yuxiaolejs/models/nuc-1u-mount-PartA_NUC_tray.stl

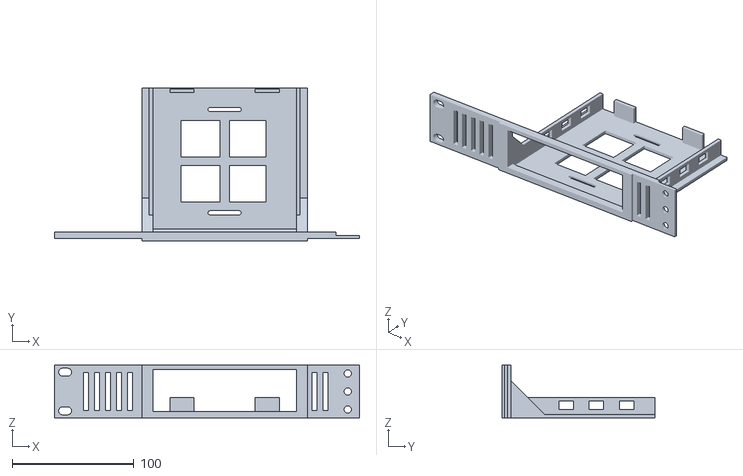
[picture p1: CAD file, 2026-07-30]
nuc-1u-mount-PartA_NUC_tray.stl
251.0 x 125.5 x 43.6
