yuxiaolejs/models/rack-panel.FCStd

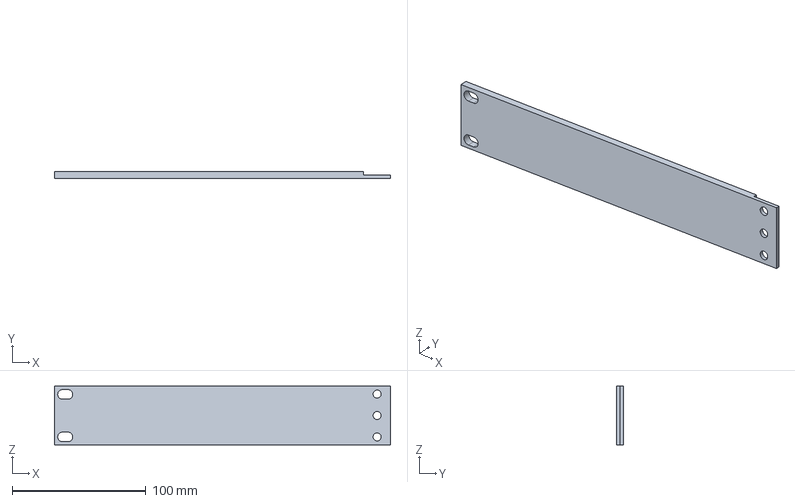
[picture p2: CAD file, 2026-07-30]
rack-panel.FCStd
251.0 x 5.00 x 44.0 mm
