yuxiaolejs/models/(commit log)

2026-07-30 Add parametric 1U NUC mount generator, forked from rack-panel
    Generator for a two-part 19" 1U rack mount holding an Intel NUC 11 slim
    (117 x 112 x 37). Both halves land at 251.0 mm to fit the 256 bed.
    Rack geometry corrected against EIA-310 vs. the original rack-panel:
    - 482.6 wide (was 482.0), 43.6 tall (was 44.0; h = 44.45n - 0.79)
    - ear slots 8.75 in from each edge, so 465.10 centres AND mirror
    symmetric -- the original half mirrored to 466.0
    - 0.2 mm clearance in the half-lap (was an exact 0.0 press fit)
    Tray: 2.8 mm floor, continuous 14 mm side walls, 28 mm corner webs and a
    full-width haunch at the panel junction. Measured section stiffness is
    26x a bare plate mid-span, ~0.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
    [nuc-1u-mount-PartA_NUC_tray.stl, rack-panel.FCStd]
2026-07-30 Move NUC forward 2 mm, shorten the tail, drop the rear stops
    Three fit fixes from test-fitting v1:
    - NUC sits 2 mm closer to the panel. Port recess goes 7.5 -> 5.5 mm, i.e.
    the panel thickness plus 0.5 mm of clearance. To free that 2 mm the
    junction haunch now passes UNDER the front lip of the chassis, in the
    3 mm gap the rubber feet leave, instead of in front of it: 2.5 mm tall
    outboard of the pocket where it has room, 1.5 mm across the pocket.
    New NUC_FOOT_H makes that assumption explicit and leaves 1.5 mm of
    margin if the feet are shorter than assumed.
    - Tail shortened. The floor used to follow the NUC to y = 123.5; it now
    stops at FLOOR_Y1 = 112, driven by FLOOR_TAIL = 5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
2026-10-19 Add parametric 1U MOTU M2 conversion, forked from the NUC mount
    The stock M2 can't go in 1U on any tray: the aluminum shell is 44.73 mm
    outside against 43.66 max. Its front and rear plates are only 40 mm and
    the internals clear 38.6, so the shell is replaced by a thinner printed
    one built into the rack panel; plates and PCB are reused untouched.
    Copies the stock construction: plates + PCB screw into one spool with
    the PCB as the strut, each plate seats in a rebate with a 1 mm lip, and
    the shell is trapped between them. The front rebate is cut into the
    rack panel so the MOTU face sits flush in the rack.
    - plate 185.6 x 40 R9, cavity 183.6 x 38.7, 103.5 lip to lip
    - walls 1.6 at the reba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
